janavi2008/JPMatrix/PCBs/JPMatrix.kicad_pcb

## KiCad design PCBs/JPMatrix.kicad_pcb (2026-11-01)

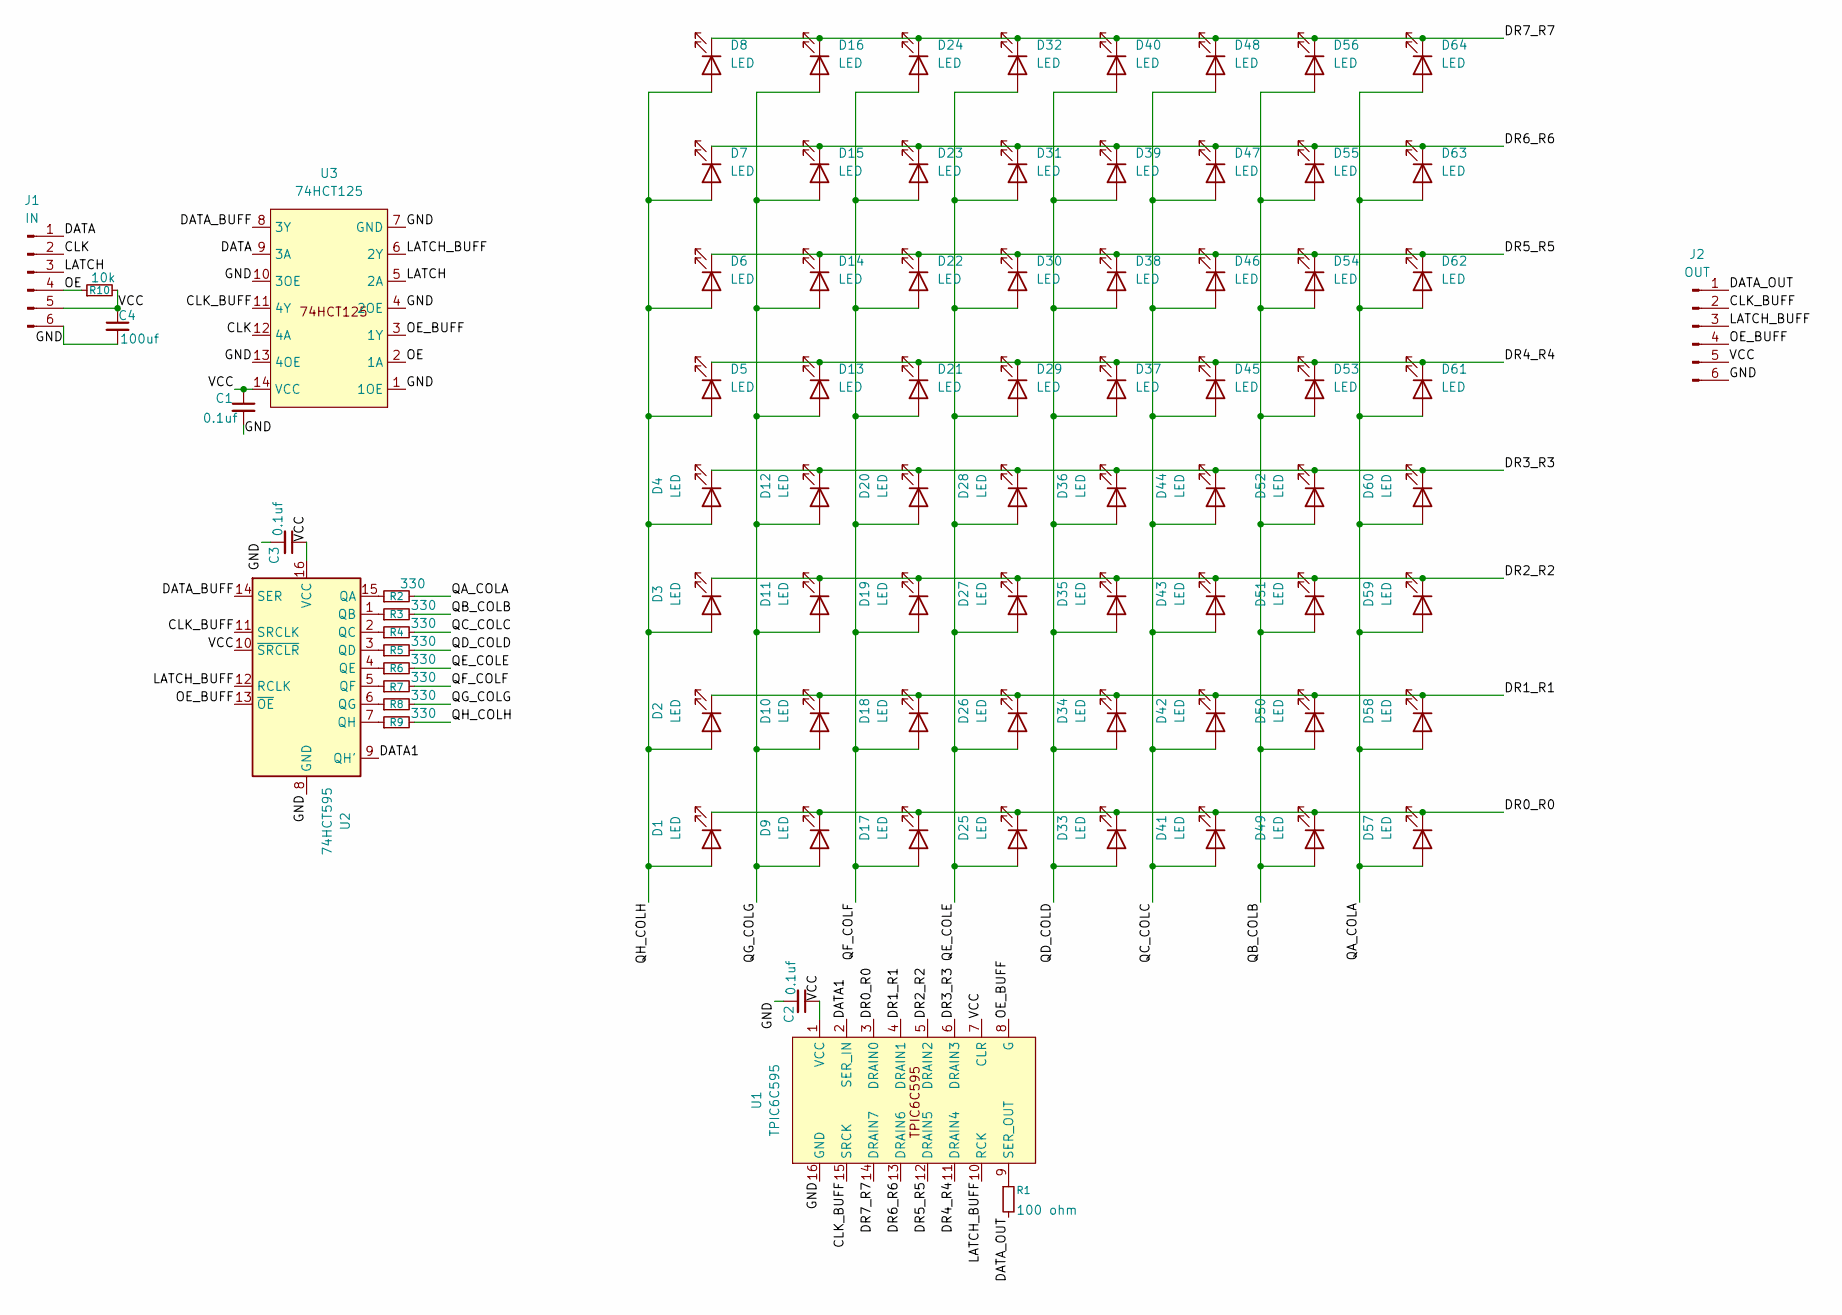
[picture p1: schematic JPMatrix.kicad_sch]

Parts:
C1, C2, C3: 0.1uf; C_0603_1608Metric_Pad1.08x0.95mm_HandSolder
C4: 100uf; CP_Elec_6.3x5.9
D1, D2, D3, D4, D5, D6, D7, D8, D9, D10, D11, D12, D13, D14, D15, D16, D17, D18, D19, D20, D21, D22, D23, D24, D25, D26, D27, D28, D29, D30, D31, D32, D33, D34, D35, D36, D37, D38, D39, D40, D41, D42, D43, D44, D45, D46, D47, D48, D49, D50, D51, D52, D53, D54, D55, D56, D57, D58, D59, D60, D61, D62, D63, D64: LED; LED_0805_2012Metric_Pad1.15x1.40mm_HandSolder
J1: IN; PinHeader_1x06_P2.54mm_Vertical
J2: OUT; PinHeader_1x06_P2.54mm_Vertical
R1: 100 ohm; R_0603_1608Metric_Pad0.98x0.95mm_HandSolder
R2, R3, R4, R5, R6, R7, R8, R9: 330; R_0603_1608Metric_Pad0.98x0.95mm_HandSolder
R10: 10k; R_0603_1608Metric_Pad0.98x0.95mm_HandSolder
U1: TPIC6C595; SOIC-16_3.9x9.9mm_P1.27mm
U2: 74HCT595; SOIC-16_3.9x9.9mm_P1.27mm
U3: 74HCT125; TSSOP-14_4.4x5mm_P0.65mm

Connections:
/CLK: J1.2, U3.12 (4A)
/CLK_BUFF: J2.2, U1.15 (SRCK), U2.11 (SRCLK), U3.11 (4Y)
/DATA: J1.1, U3.9 (3A)
/DATA1: U1.2 (SER_IN), U2.9 (QH')
/DATA_BUFF: U2.14 (SER), U3.8 (3Y)
/DATA_OUT: J2.1, R1.2
/DR0_R0: D1.1 (K), D9.1 (K), D17.1 (K), D25.1 (K), D33.1 (K), D41.1 (K), D49.1 (K), D57.1 (K), U1.3 (DRAIN0)
/DR1_R1: D2.1 (K), D10.1 (K), D18.1 (K), D26.1 (K), D34.1 (K), D42.1 (K), D50.1 (K), D58.1 (K), U1.4 (DRAIN1)
/DR2_R2: D3.1 (K), D11.1 (K), D19.1 (K), D27.1 (K), D35.1 (K), D43.1 (K), D51.1 (K), D59.1 (K), U1.5 (DRAIN2)
/DR3_R3: D4.1 (K), D12.1 (K), D20.1 (K), D28.1 (K), D36.1 (K), D44.1 (K), D52.1 (K), D60.1 (K), U1.6 (DRAIN3)
/DR4_R4: D5.1 (K), D13.1 (K), D21.1 (K), D29.1 (K), D37.1 (K), D45.1 (K), D53.1 (K), D61.1 (K), U1.11 (DRAIN4)
/DR5_R5: D6.1 (K), D14.1 (K), D22.1 (K), D30.1 (K), D38.1 (K), D46.1 (K), D54.1 (K), D62.1 (K), U1.12 (DRAIN5)
/DR6_R6: D7.1 (K), D15.1 (K), D23.1 (K), D31.1 (K), D39.1 (K), D47.1 (K), D55.1 (K), D63.1 (K), U1.13 (DRAIN6)
/DR7_R7: D8.1 (K), D16.1 (K), D24.1 (K), D32.1 (K), D40.1 (K), D48.1 (K), D56.1 (K), D64.1 (K), U1.14 (DRAIN7)
/GND: C1.2, C2.2, C3.2, C4.2, J1.6, J2.6, U1.16 (GND), U2.8 (GND), U3.1 (1OE), U3.4 (2OE), U3.7 (GND), U3.10 (3OE), U3.13 (4OE)
/LATCH: J1.3, U3.5 (2A)
/LATCH_BUFF: J2.3, U1.10 (RCK), U2.12 (RCLK), U3.6 (2Y)
/OE: J1.4, R10.1, U3.2 (1A)
/OE_BUFF: J2.4, U1.8 (G), U2.13 (~OE), U3.3 (1Y)
/QA_COLA: D57.2 (A), D58.2 (A), D59.2 (A), D60.2 (A), D61.2 (A), D62.2 (A), D63.2 (A), D64.2 (A), R2.2
/QB_COLB: D49.2 (A), D50.2 (A), D51.2 (A), D52.2 (A), D53.2 (A), D54.2 (A), D55.2 (A), D56.2 (A), R3.2
/QC_COLC: D41.2 (A), D42.2 (A), D43.2 (A), D44.2 (A), D45.2 (A), D46.2 (A), D47.2 (A), D48.2 (A), R4.2
/QD_COLD: D33.2 (A), D34.2 (A), D35.2 (A), D36.2 (A), D37.2 (A), D38.2 (A), D39.2 (A), D40.2 (A), R5.2
/QE_COLE: D25.2 (A), D26.2 (A), D27.2 (A), D28.2 (A), D29.2 (A), D30.2 (A), D31.2 (A), D32.2 (A), R6.2
/QF_COLF: D17.2 (A), D18.2 (A), D19.2 (A), D20.2 (A), D21.2 (A), D22.2 (A), D23.2 (A), D24.2 (A), R7.2
/QG_COLG: D9.2 (A), D10.2 (A), D11.2 (A), D12.2 (A), D13.2 (A), D14.2 (A), D15.2 (A), D16.2 (A), R8.2
/QH_COLH: D1.2 (A), D2.2 (A), D3.2 (A), D4.2 (A), D5.2 (A), D6.2 (A), D7.2 (A), D8.2 (A), R9.2
/VCC: C1.1, C2.1, C3.1, C4.1, J1.5, J2.5, R10.2, U1.1 (VCC), U1.7 (CLR), U2.10 (~SRCLR), U2.16 (VCC), U3.14 (VCC)
unnamed: R1.1, U1.9 (SER_OUT)
unnamed: R2.1, U2.15 (QA)
unnamed: R3.1, U2.1 (QB)
unnamed: R4.1, U2.2 (QC)
unnamed: R5.1, U2.3 (QD)
unnamed: R6.1, U2.4 (QE)
unnamed: R7.1, U2.5 (QF)
unnamed: R8.1, U2.6 (QG)
unnamed: R9.1, U2.7 (QH)

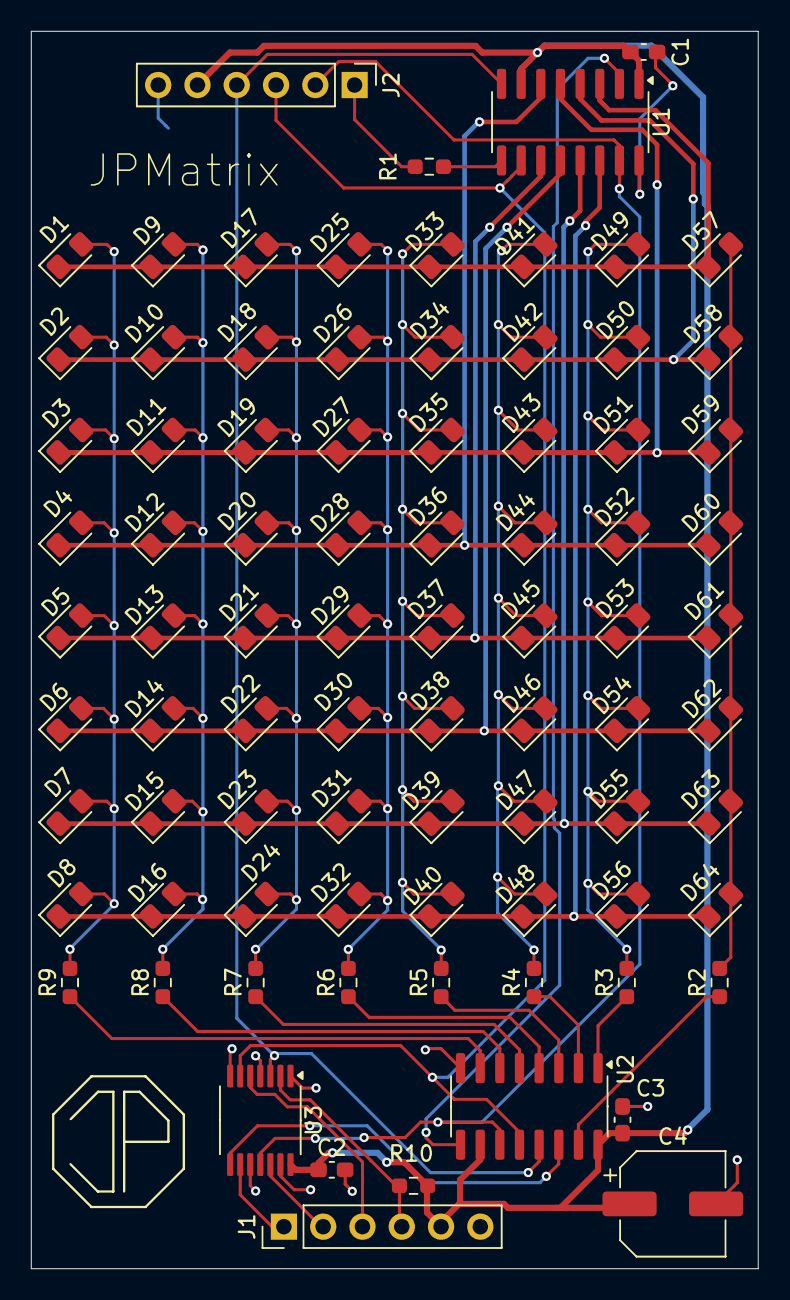
[picture p2: board JPMatrix.kicad_pcb from above]

Board: 2 copper layers, 47.0 x 80.0 mm, 83 parts (0 on the bottom side), 37 nets.
