janavi2008/JPMatrix/(commit log)

2026-11-01 Sync JPMatrix from Half Life
    [BOM.csv]
2026-11-01 Rename Untitled spreadsheet - Sheet1 (4).csv to BOM.csv
    [BOM.csv]
